WARMW00D/DUAL-CANFD-ESP32-C5-Sniffer/docs/Scheme Dual channels CAN-Sniffer ESP32-C5 based RUS.png

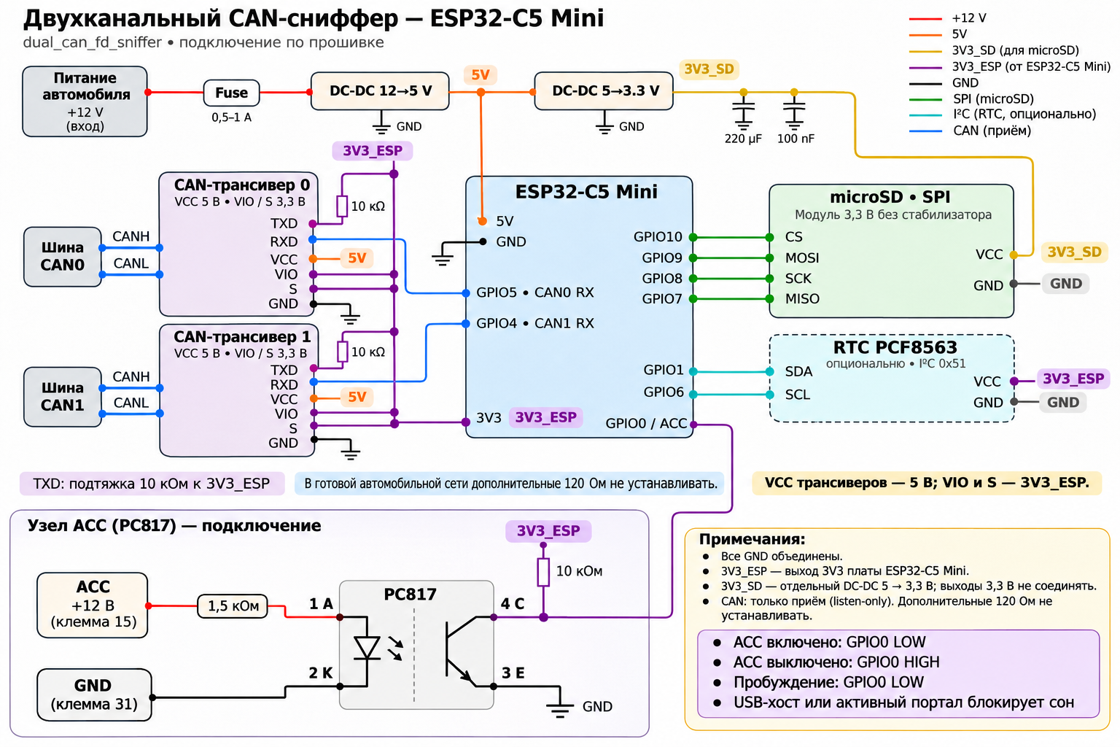
docs/Scheme Dual channels CAN-Sniffer ESP32-C5 based RUS.png
