WARMW00D/DUAL-CANFD-ESP32-C5-Sniffer/(commit log)

2026-11-05 Rename Scheme Dual channels CAN-Sniffer ESP32-C5 based EN.png to docs/Scheme Dual channels CAN-Sniffer ESP32-C5 based EN.png
2026-11-05 Rename Scheme Dual channels CAN-Sniffer ESP32-C5 based RUS.png to docs/Scheme Dual channels CAN-Sniffer ESP32-C5 based RUS.png
2026-11-05 Rename heatshrink_common.h to src/heatshrink /heatshrink_common.h
